abb94/Label-Applicator/pictures/roller_cylinder.jpg

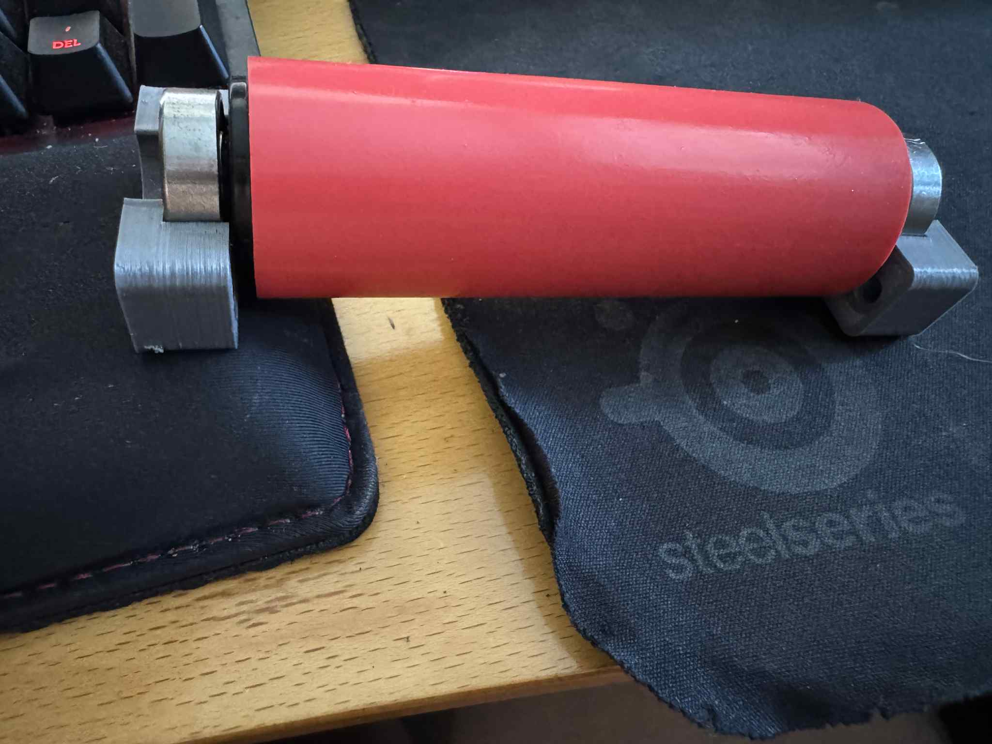
pictures/roller_cylinder.jpg
