abb94/Label-Applicator/pictures/cylinders_1.jpg

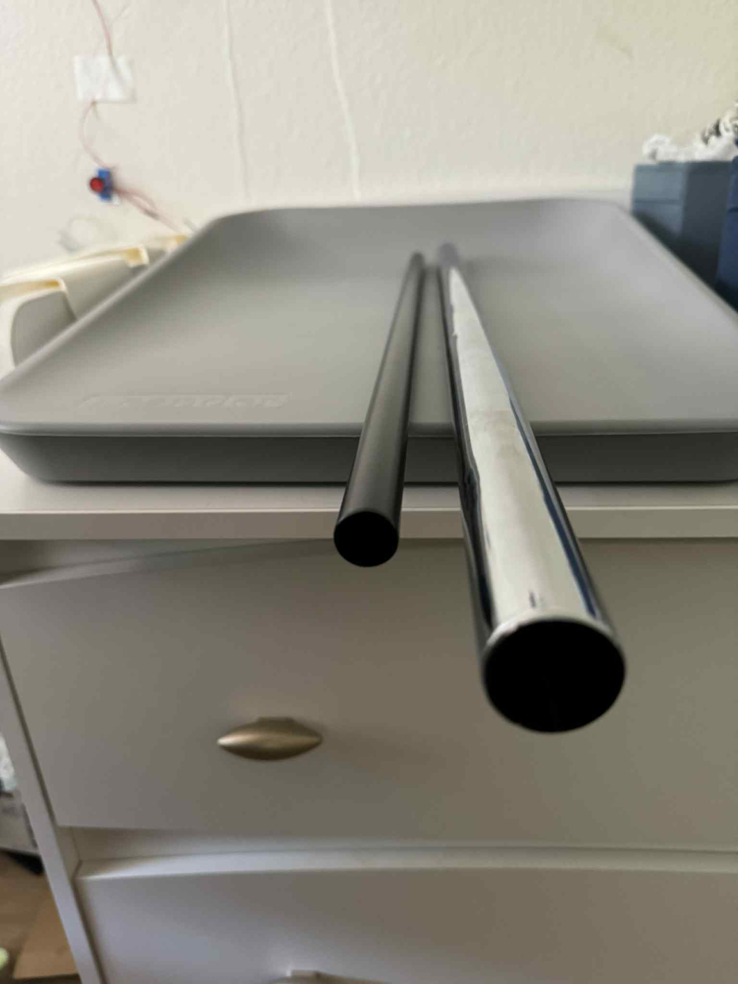
pictures/cylinders_1.jpg
