abb94/Label-Applicator/README.md

# 🏷️ Automated Label Applicator

The goal for this project is to make a cheap and automated DIY Label Applicator for small bottles and flasks with adjustable size, relative to the bottle placed on the device. 

---

## 📚 Table of Contents

- [Introduction](#-introduction)
- [Requirements](#-requirements)
- [Features](#-features)
- [Hardware](#-hardware)
- [Software](#-software)
- [Installation](#-installation)
- [Design Files](#-design-files)
- [Roadmap](#-roadmap)
- [Log](#-log)
- [Learnings](#-learnings)

---

## 🔍 Introduction

This project was created for a friend who is passionate about honey farming. In 2024, his bee colonies produced nearly half a ton of honey. Since each bottle contains roughly half a kilo, that’s about 1,000 bottles to label by hand — a task that’s both time-consuming and far from the most enjoyable part of beekeeping. Commercial automatic label applicators are notoriously expensive, so this project aims to develop a more affordable alternative.

---

## ‼️: Requirements

- [ ] Easy to move around. 
- [ ] Apply labels on different dimensions of glass and label sizes. 
- [ ] Easy to maintain.
- [ ] Easy to use.
- [ ] Semi-automatic and manual to operate. 

---

## ✨ Features

<!-- List the features, for example: automatic feed, sensor detection, calibration, etc. -->

---

## 🔩 Hardware

- 2 x 20 mm x 20 mm x 60 mm I-type profiles
- 3 x 20 mm x 20 mm x 15 mm I-type profiles

---

## 🧠 Software

<!-- Describe the software architecture, languages, frameworks, and any libraries used. -->

---

## ⚙️ Installation

<!-- Step-by-step guide to installing and running the project. Include wiring diagrams or schematics if relevant. -->

---

## 🖼️ Design Files

Current socket design: <br>

Uden titel

---
### 📄: Learnings
- Create a component as the first thing in Fusion 360. Create the body, and the sketch creating that body, and keep it inside the component.
- Tolerances are difficult on a 3d Printer.
- Standardize as much as possible, and don't create several parts from one origin, that fits a niche purpose. It is easier to have the original modified so that it coveres all requirements. 

---
