abb94/Label-Applicator/pictures/3d model socket_on_profile.png

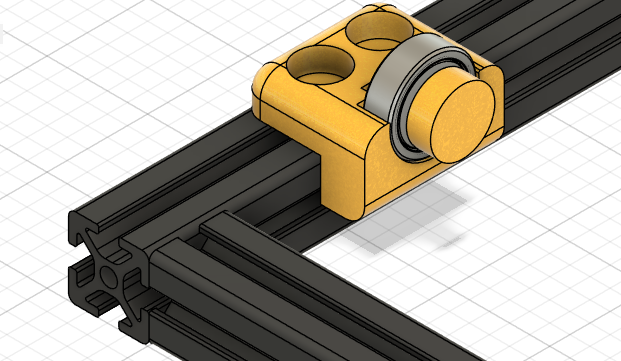
pictures/3d model socket_on_profile.png
