abb94/Label-Applicator/pictures/cylinders_2.jpg

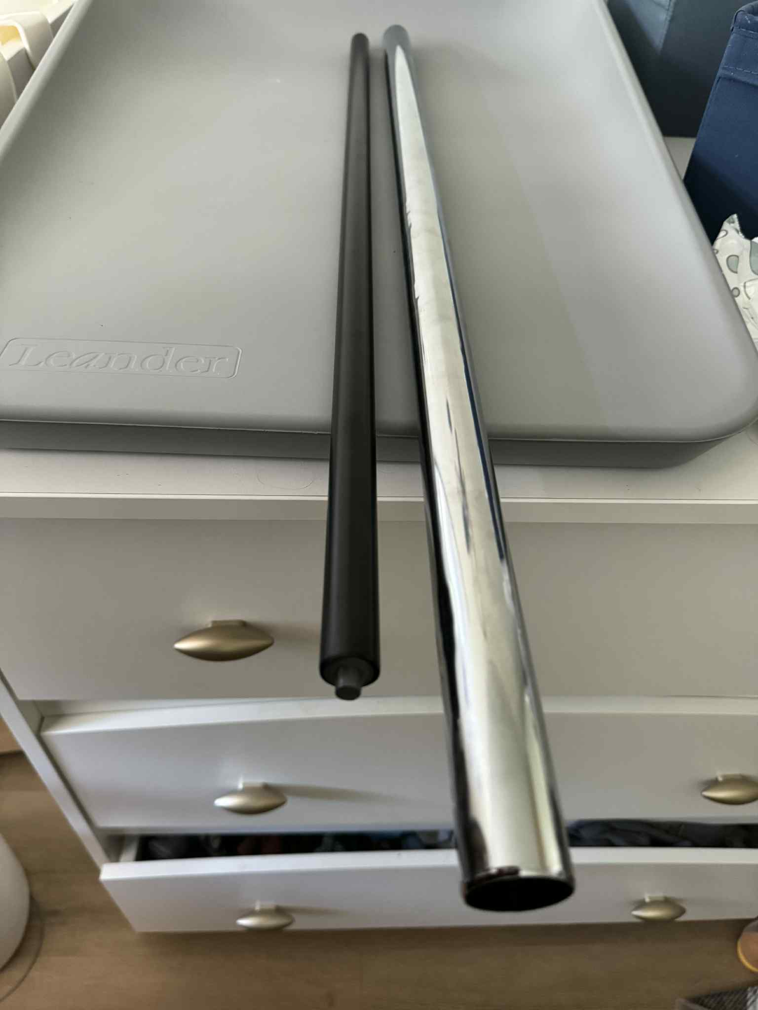
pictures/cylinders_2.jpg
