abb94/Label-Applicator/pictures/profile_bearing_socket_1.jpg

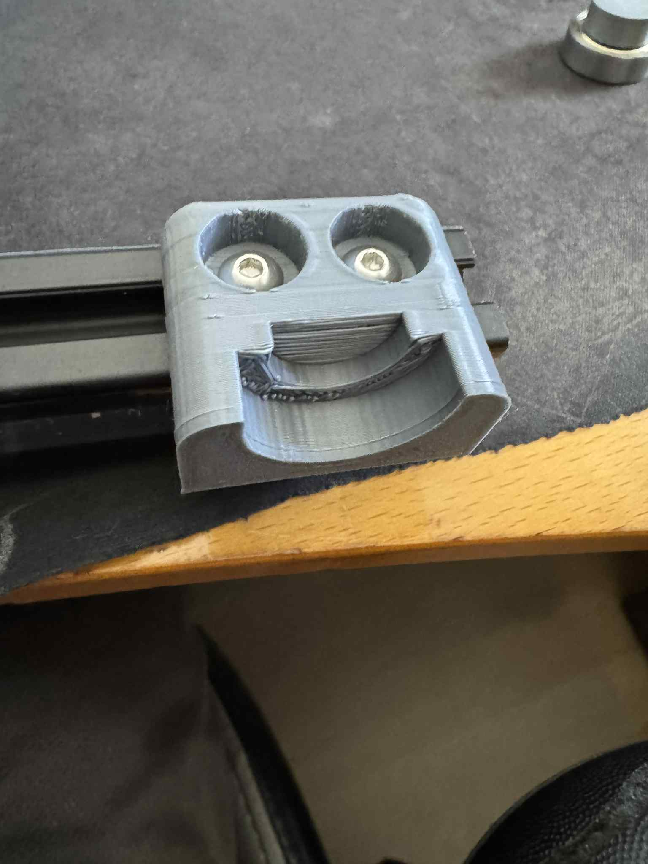
pictures/profile_bearing_socket_1.jpg
