abb94/Label-Applicator/pictures/profile_bearing_socket_2.jpg

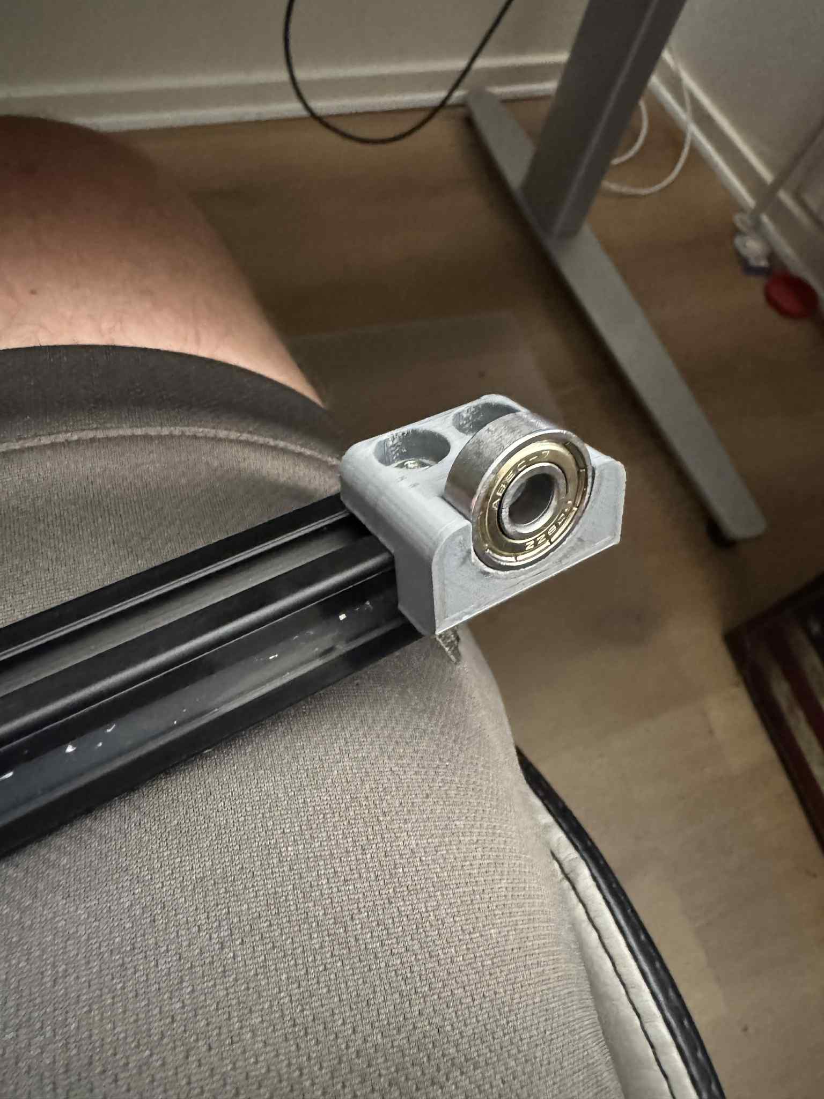
pictures/profile_bearing_socket_2.jpg
