abb94/Label-Applicator/Fusion 360 sketches/Framing_Socket_Sketch.dxf

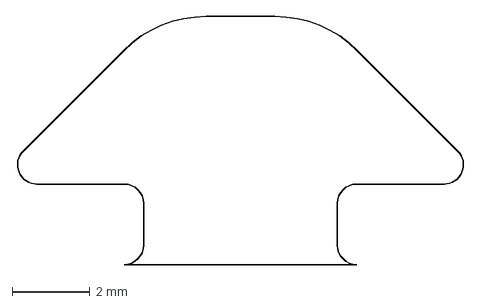
[picture p7: CAD file, 2025-08-17]
Fusion 360 sketches/Framing_Socket_Sketch.dxf
11.6 x 6.40 mm
