abb94/Label-Applicator/STL files/Bearings 8x22x7.step

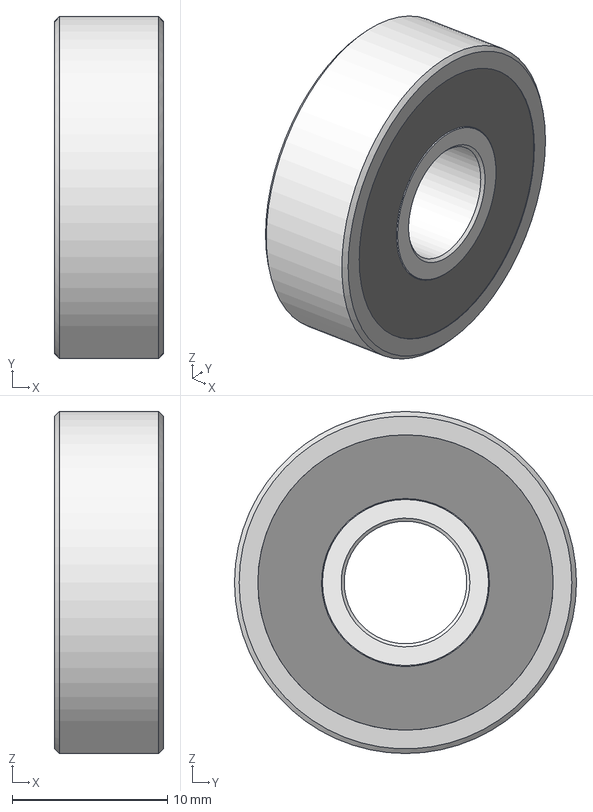
[picture p8: CAD file, 2026-10-25]
STL files/Bearings 8x22x7.step
7.00 x 22.0 x 22.0 mm
Nedre ringen
Mellan ringen
Yttre ringen
Kula x 7
Sidoskydd x 2
