abb94/Label-Applicator/STL files/profile bearing socket/Bearing socket.stl

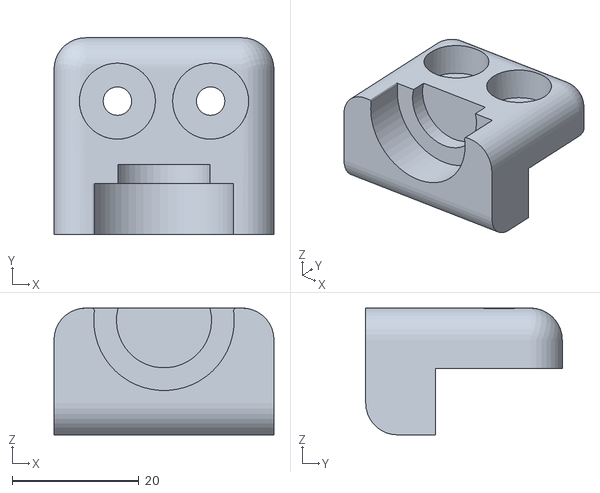
[picture p9: CAD file, 2025-08-17]
STL files/profile bearing socket/Bearing socket.stl
34.7 x 31.0 x 20.0
