abb94/Label-Applicator/STL files/WIP/bridge.stl

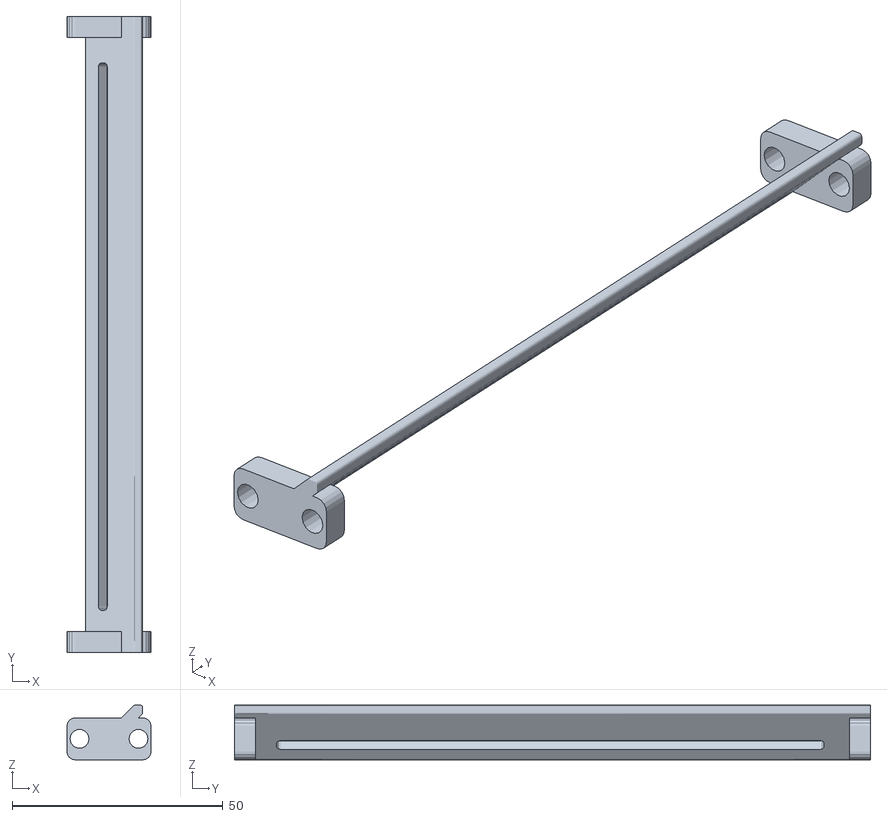
[picture p10: CAD file, 2026-02-08]
STL files/WIP/bridge.stl
20.0 x 151.0 x 13.0
