abb94/Label-Applicator/STL files/WIP/spool allign rod.stl

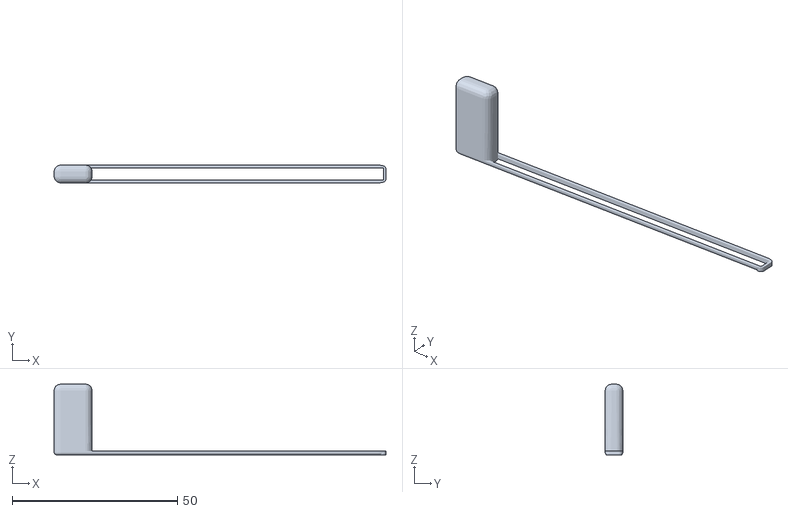
[picture p11: CAD file, 2026-02-08]
STL files/WIP/spool allign rod.stl
100.3 x 5.40 x 21.4
