abb94/Label-Applicator/STL files/WIP/Motorbracket.stl

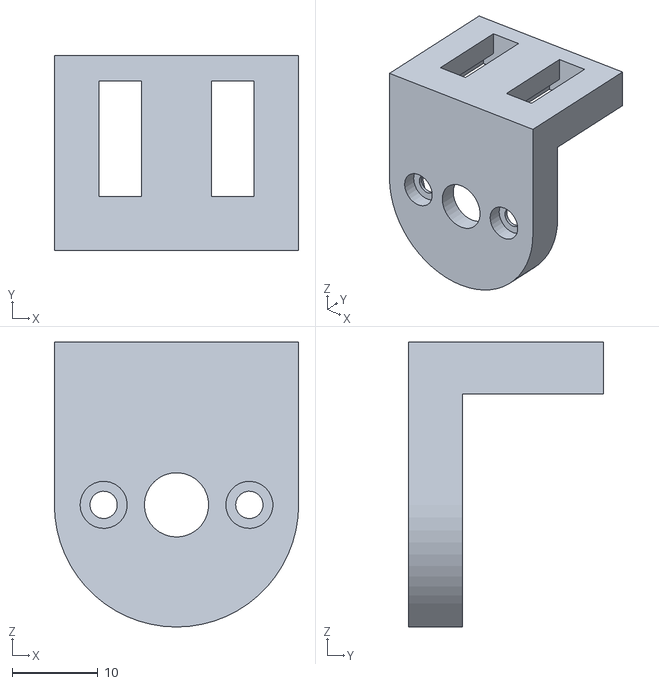
[picture p12: CAD file, 2026-02-08]
STL files/WIP/Motorbracket.stl
28.5 x 22.8 x 33.2
