abb94/Label-Applicator/STL files/WIP/small_fit_adjusted_label.stl

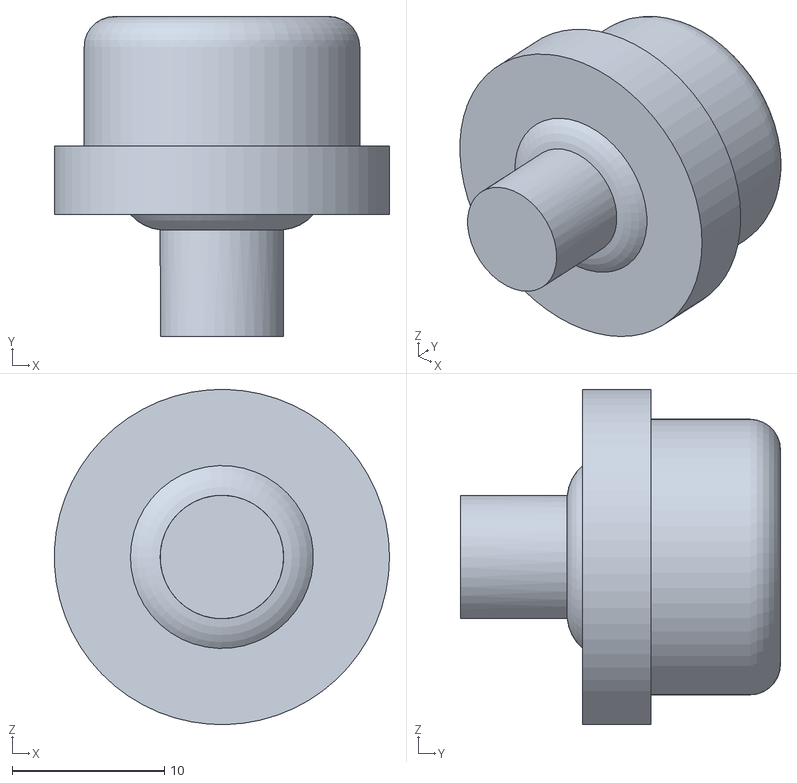
[picture p13: CAD file, 2026-02-08]
STL files/WIP/small_fit_adjusted_label.stl
22.0 x 21.0 x 22.0
