abb94/Label-Applicator/STL files/WIP/BridgeHandle_left.stl

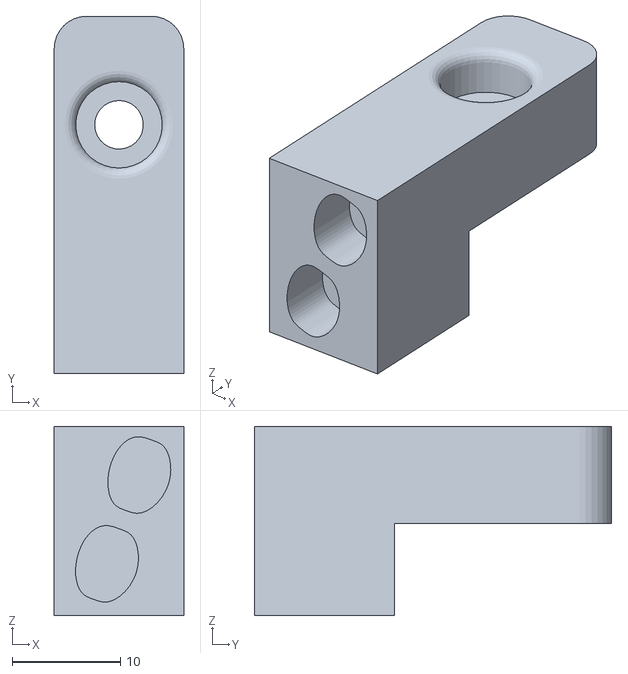
[picture p14: CAD file, 2026-02-08]
STL files/WIP/BridgeHandle_left.stl
12.0 x 33.1 x 17.5
