abb94/Label-Applicator/STL files/WIP/bund.stl

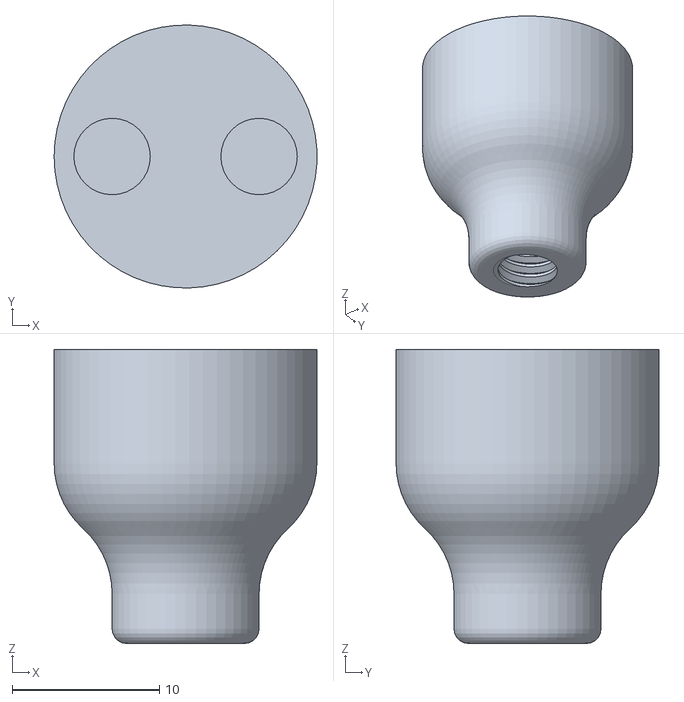
[picture p15: CAD file, 2026-02-08]
STL files/WIP/bund.stl
17.9 x 17.9 x 20.0
