abb94/Label-Applicator/STL files/WIP/label spool holder .stl

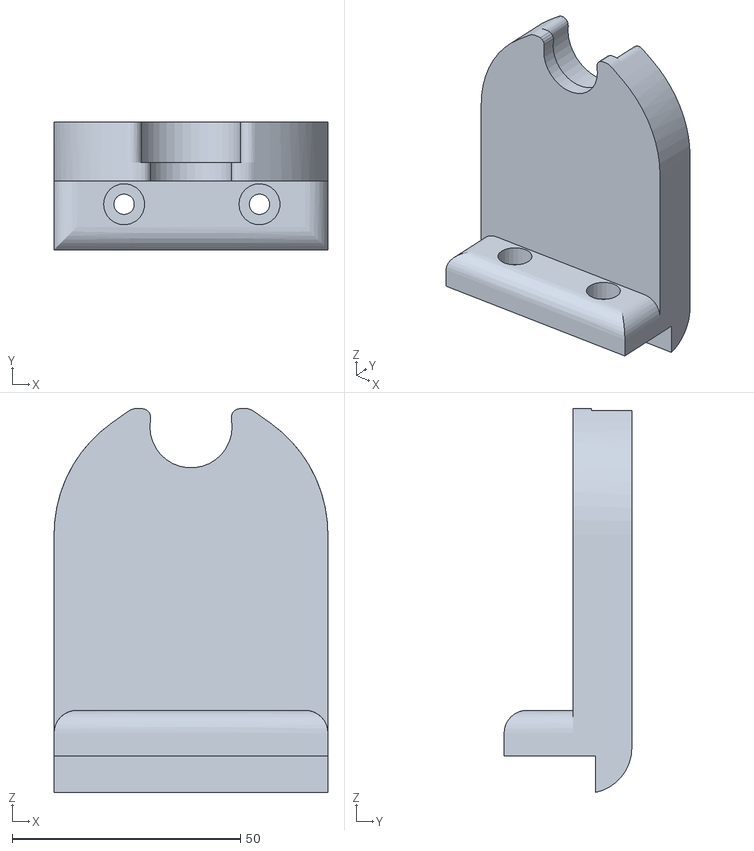
[picture p16: CAD file, 2026-02-08]
STL files/WIP/label spool holder .stl
60.0 x 28.0 x 84.1
