abb94/Label-Applicator/STL files/WIP/test.stl

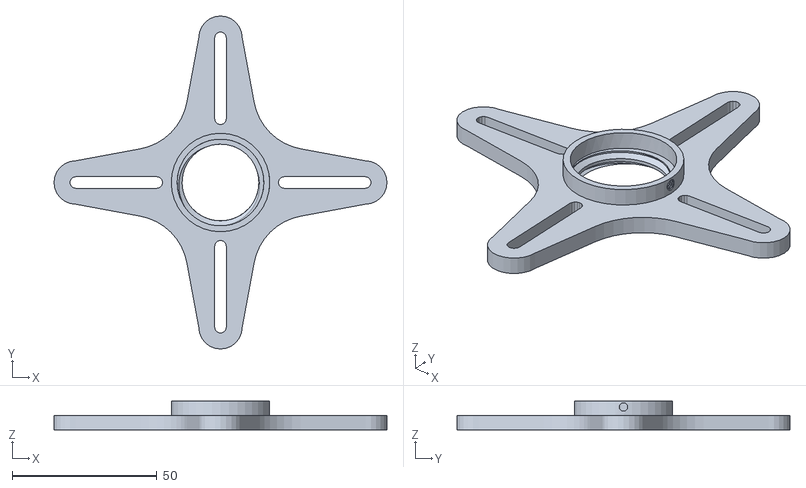
[picture p17: CAD file, 2026-02-08]
STL files/WIP/test.stl
115.0 x 115.0 x 10.0
