abb94/Label-Applicator/STL files/WIP/spool allign socket.stl

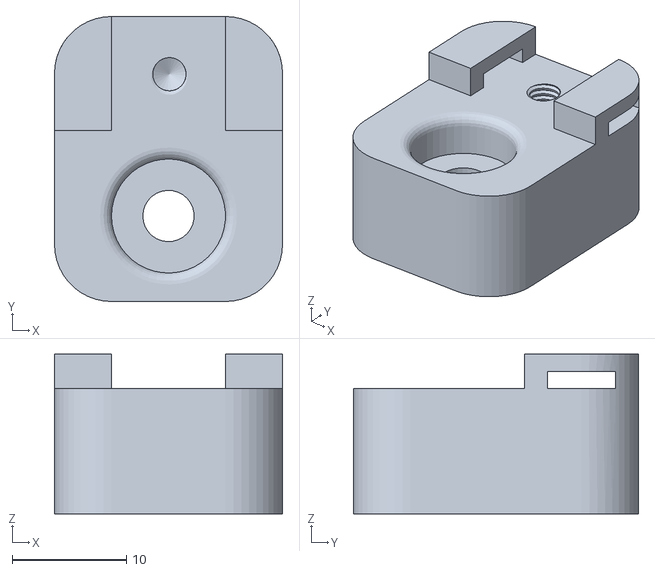
[picture p18: CAD file, 2026-02-08]
STL files/WIP/spool allign socket.stl
20.0 x 25.0 x 14.0
