abb94/Label-Applicator/STL files/WIP/Stand socket.stl

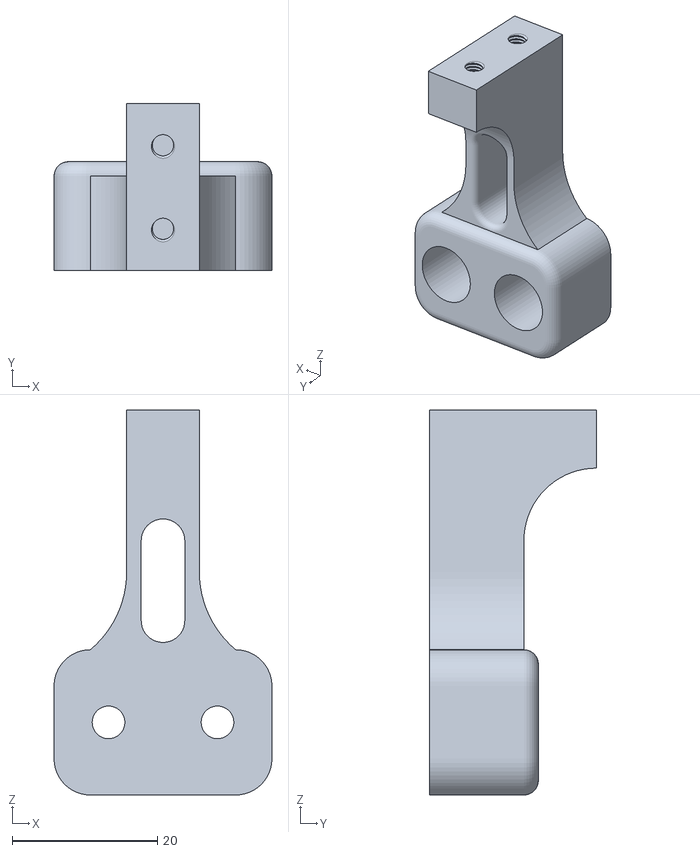
[picture p19: CAD file, 2026-02-08]
STL files/WIP/Stand socket.stl
30.0 x 23.0 x 53.0
