abb94/Label-Applicator/STL files/WIP/kombineret fod.stl

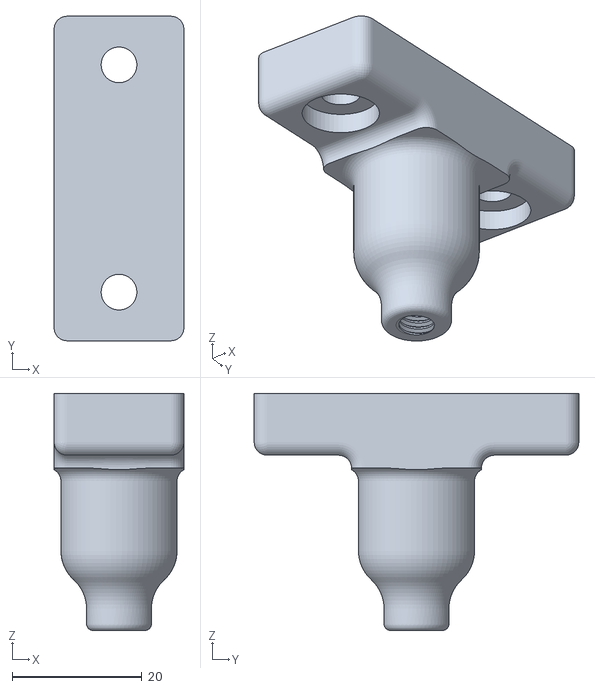
[picture p20: CAD file, 2026-02-08]
STL files/WIP/kombineret fod.stl
20.0 x 50.0 x 36.5
