abb94/Label-Applicator/STL files/WIP/top.stl

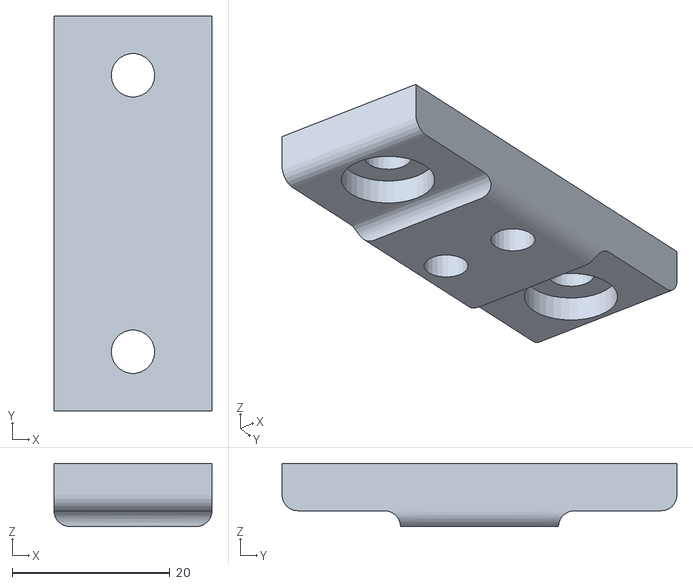
[picture p21: CAD file, 2026-02-08]
STL files/WIP/top.stl
20.0 x 50.0 x 8.00
