abb94/Label-Applicator/STL files/WIP/IR holder stand.stl

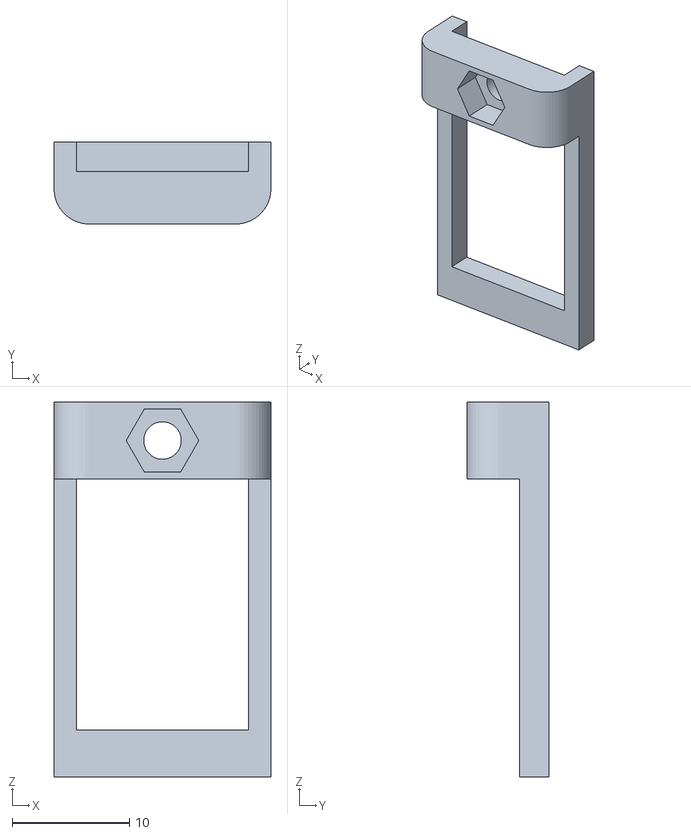
[picture p22: CAD file, 2026-02-08]
STL files/WIP/IR holder stand.stl
18.5 x 7.00 x 32.0
