abb94/Label-Applicator/STL files/WIP/small fit.stl

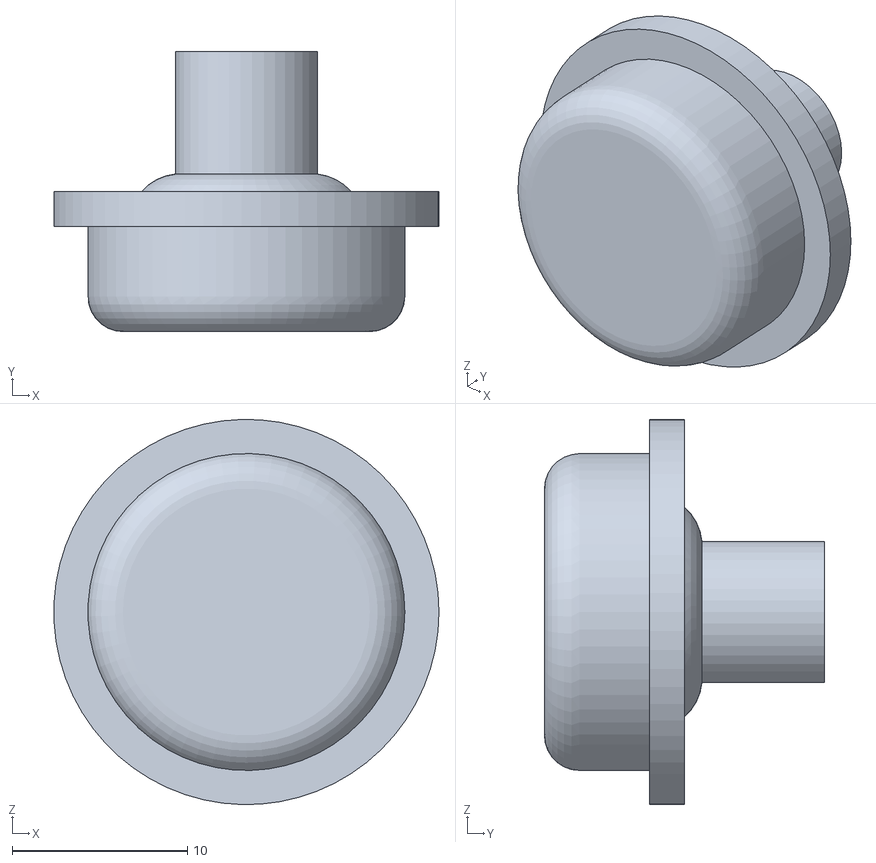
[picture p23: CAD file, 2026-02-08]
STL files/WIP/small fit.stl
22.0 x 16.0 x 22.0
