abb94/Label-Applicator/STL files/WIP/medium fit.stl

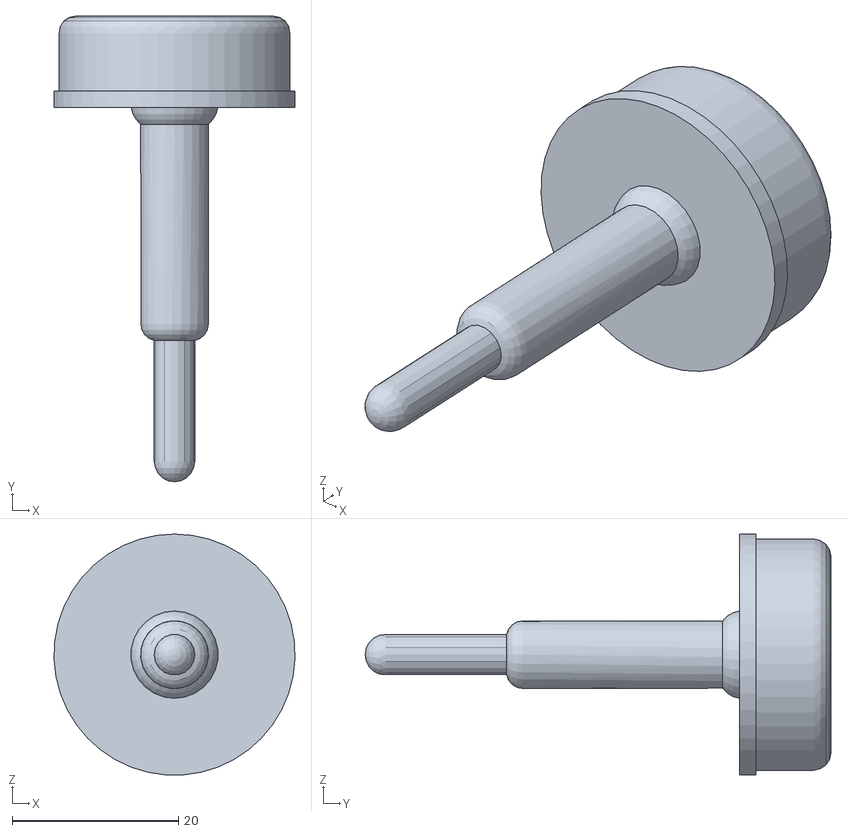
[picture p24: CAD file, 2026-02-08]
STL files/WIP/medium fit.stl
29.0 x 56.0 x 29.0
