abb94/Label-Applicator/STL files/WIP/rod.stl

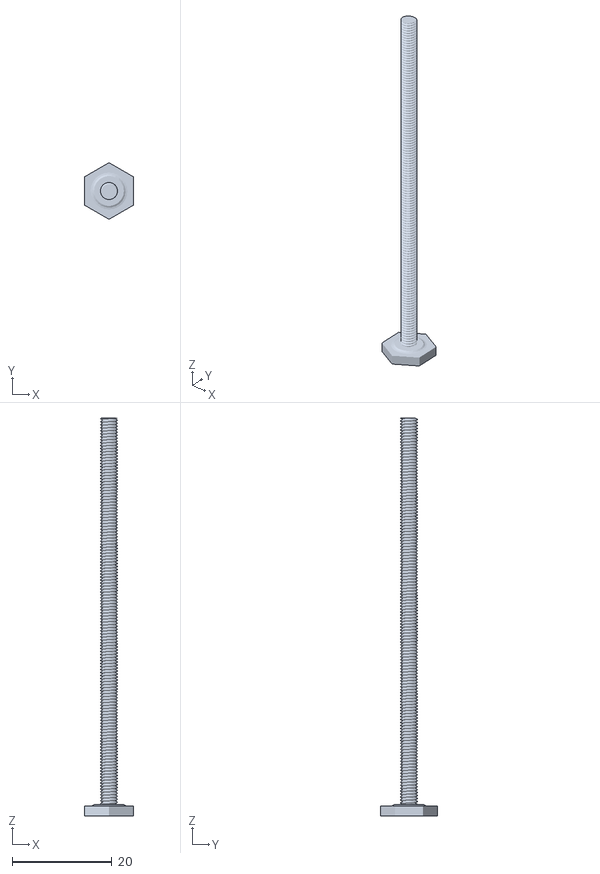
[picture p25: CAD file, 2026-02-08]
STL files/WIP/rod.stl
9.85 x 11.4 x 80.0
