abb94/Label-Applicator/STL files/WIP/test spool holder.stl

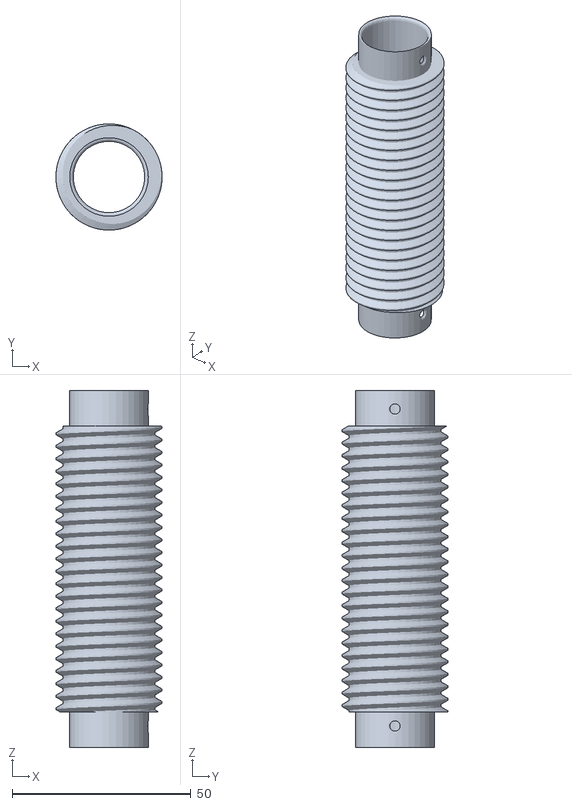
[picture p26: CAD file, 2026-02-08]
STL files/WIP/test spool holder.stl
29.7 x 29.7 x 100.0
