abb94/Label-Applicator/STL files/WIP/Stand rod.stl

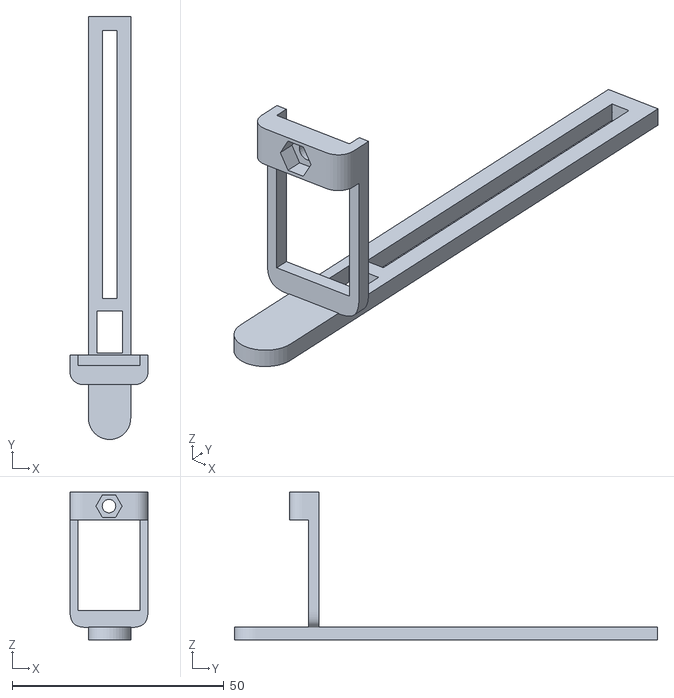
[picture p27: CAD file, 2026-02-08]
STL files/WIP/Stand rod.stl
18.5 x 100.0 x 34.9
