abb94/Label-Applicator/STL files/WIP/medium extended fit.stl

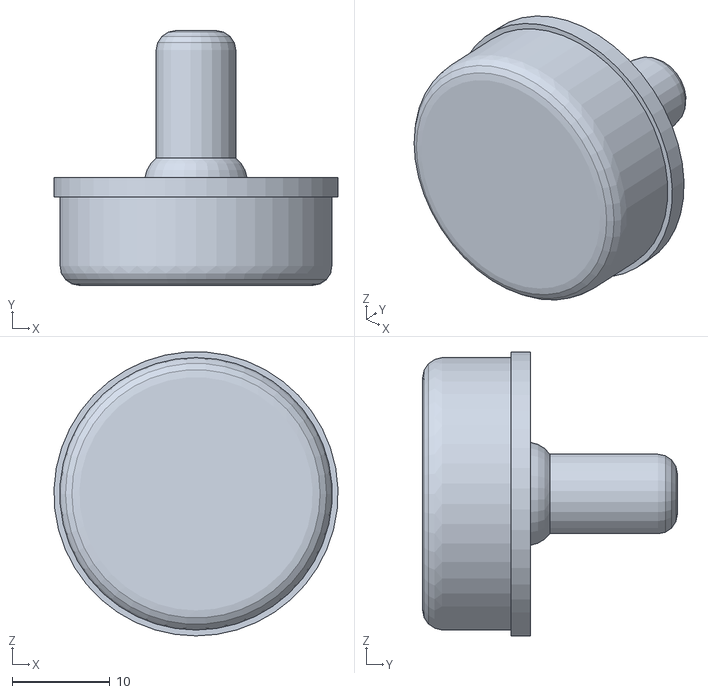
[picture p28: CAD file, 2026-02-08]
STL files/WIP/medium extended fit.stl
29.0 x 26.0 x 29.0
