abb94/Label-Applicator/STL files/WIP/label alligner.stl

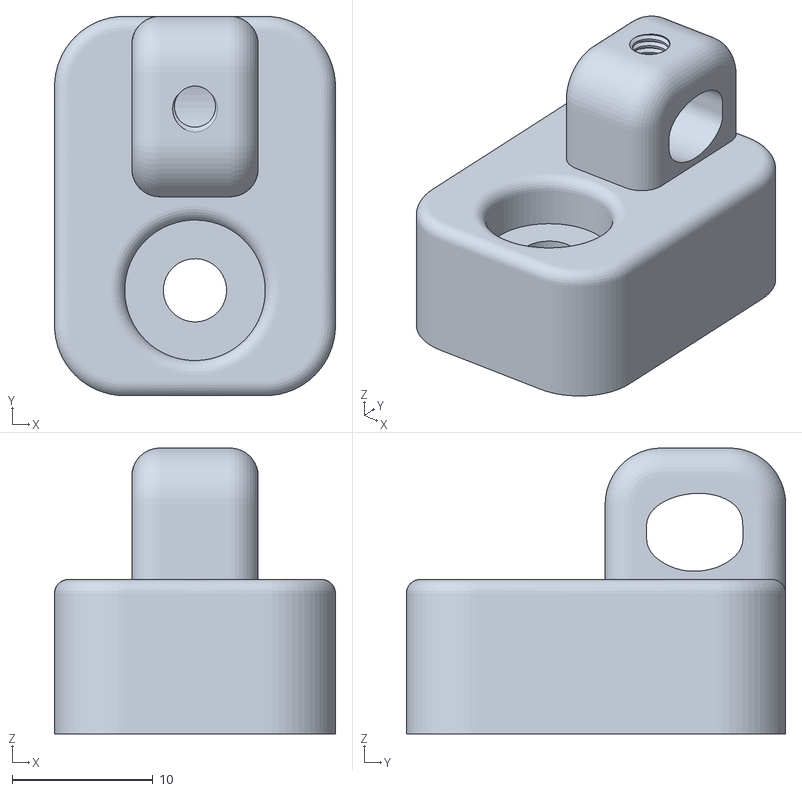
[picture p29: CAD file, 2026-02-08]
STL files/WIP/label alligner.stl
20.0 x 27.0 x 20.4
