abb94/Label-Applicator/STL files/WIP/IR holder.stl

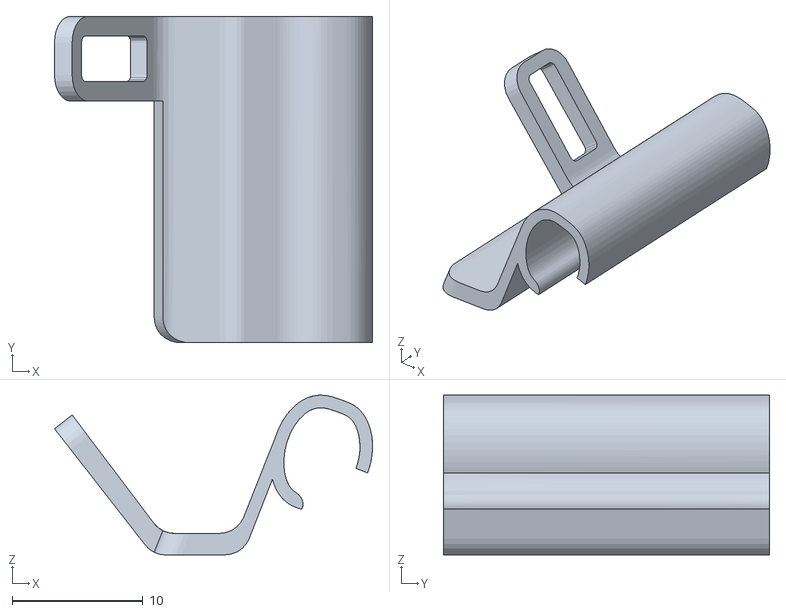
[picture p30: CAD file, 2026-02-08]
STL files/WIP/IR holder.stl
24.4 x 25.0 x 12.2
