abb94/Label-Applicator/STL files/WIP/small socket.stl

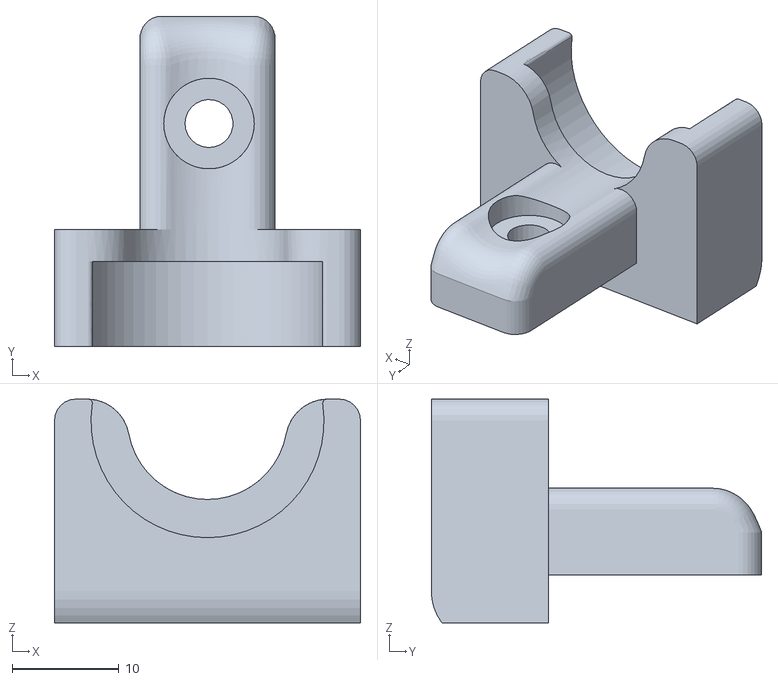
[picture p31: CAD file, 2026-02-08]
STL files/WIP/small socket.stl
28.7 x 31.0 x 21.0
