abb94/Label-Applicator/STL files/WIP/Lille 1.stl

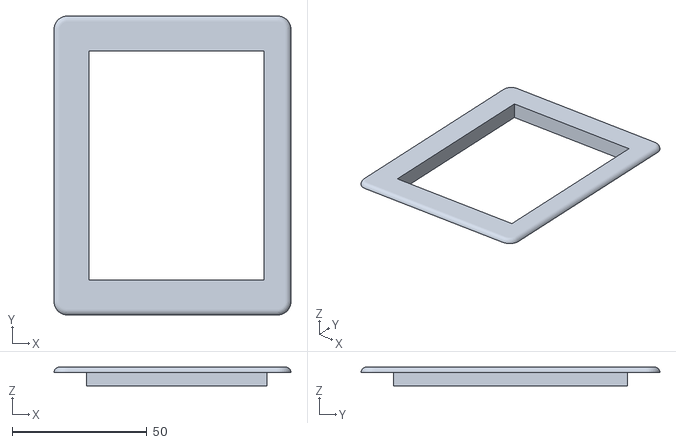
[picture p32: CAD file, 2026-02-08]
STL files/WIP/Lille 1.stl
88.0 x 111.0 x 7.00
