abb94/Label-Applicator/(list of files, cad)

Other CAD files:
STL files/WIP/small_fit_right.stl
STL files/WIP/test2.stl
STL files/WIP/BridgeHandle.stl
STL files/WIP/BridgeHandle_Right.stl
STL files/Assembled Bearing 8x22x7 v15.f3z
STL files/NEMA17 stepper motor v39.f3d
STL files/WIP/bolt.stl
STL files/WIP/feet screw.stl
STL files/WIP/label spool holder.stl
