abb94/Label-Applicator/Logs/V2 - Current build.md

## 📗: Log

### 25th of October 2026 <br>

I disassembled my version 1 today. The biggest issue on the last version was: 
- My choice of IR sensor. 
- The sudden stop of momentum from the motor, resulting in a "loose" circuit from the spool input and until it was labelled upon a honey glass.

My first objective is to have a tightened loop between the spool input and spool output. 
- **Spool input**: The spool and paper with labels on, which will be applied upon the glass. 
- **Spool output**: The mechanism that *drags* the paper that has been used and removes the paper from the circuit.

I will aim to have a gear on both the input section and output section. This should reduce the possibility of momentum creating a loose circuit, since the stepper motor will stop the motion instantly in both sections of the circuit.
