abb94/Label-Applicator/PCB/Main/Main.kicad_pcb

## KiCad design PCB/Main/Main.kicad_pcb (2026-10-21)

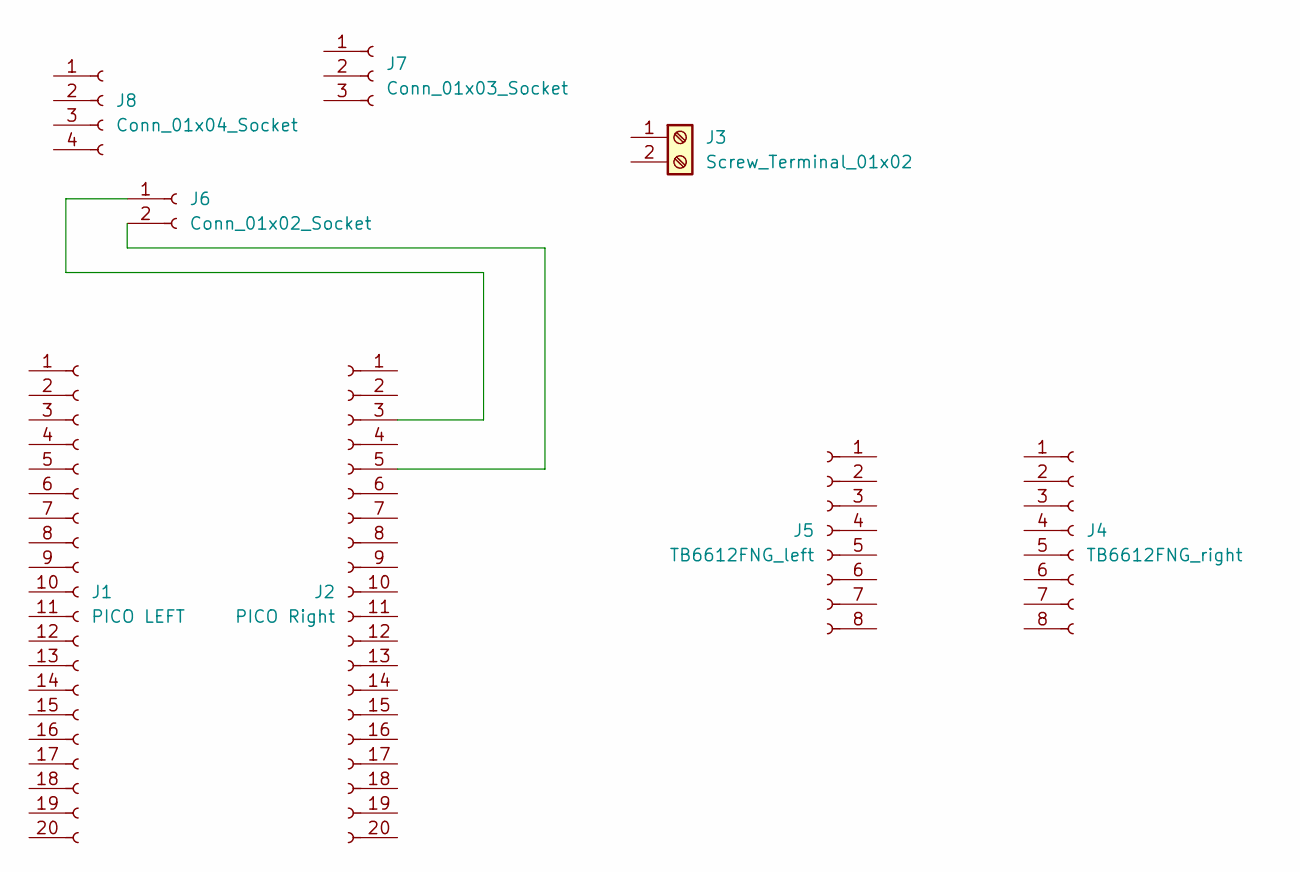
[picture p33: schematic Main.kicad_sch]

Parts:
J1: PICO LEFT; PinSocket_1x20_P2.54mm_Vertical
J2: PICO Right; PinSocket_1x20_P2.54mm_Vertical
J3: Screw_Terminal_01x02; TerminalBlock_MetzConnect_Type073_RT02602HBLU_1x02_P5.08mm_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
J4: TB6612FNG_right; PinSocket_1x08_P2.54mm_Vertical
J5: TB6612FNG_left; PinSocket_1x08_P2.54mm_Vertical
J6: Conn_01x02_Socket; JST_XH_B2B-XH-A_1x02_P2.50mm_Vertical
J7: Conn_01x03_Socket; JST_XH_B3B-XH-A_1x03_P2.50mm_Vertical
J8: Conn_01x04_Socket; JST_XH_B4B-XH-A_1x04_P2.50mm_Vertical

Connections:
unnamed: J2.3, J6.1
unnamed: J2.5, J6.2

Board: 2 copper layers, 8 parts (0 on the bottom side), 2 nets, no tracks yet.
