abb94/Label-Applicator/(commit log)

2025-08-02 Create Framing_Socket_Sketch.dxf
    Tilføjelse af sketch til profil
    [Framing_Socket_Sketch.dxf]
2025-08-17 Added pictures and maintained library.
    Added pictures and maintained library.
    [Bearing socket.stl, Framing_Socket_Sketch.dxf, Own bearing adapter 8.10 mm.stl, Own bearing adapter 8.15 mm.stl, Socket left.stl]
2026-02-08 TIlføjelse af filer.
    TIlføjelse af filer.
    [BridgeHandle.stl, BridgeHandle_Right.stl, BridgeHandle_left.stl, IR holder stand.stl, IR holder.stl, Lille 1.stl, Main.kicad_pcb, Main.kicad_sch]
2026-02-28 PCB editing
    changes to footprints.
    [Main.kicad_pcb, Main.kicad_sch]
2026-02-28 PLACED TB6612FNG Motor driver on schematic.
    [Main.kicad_pcb, Main.kicad_sch]
2026-10-03 Update README.md
    Added new log entry - Haven't worked on the project since spring of 2026.
2026-10-21 3step file
    Inserted 3step file of nema 17 42x42x23.
    [Main.kicad_pcb, Main.kicad_sch, NEMA17 stepper motor v39.f3d]
2026-10-25 Create V2 - Current build
2026-10-25 Push newest
    [Assembled Bearing 8x22x7 v15.f3z, Bearings 8x22x7.step]
2026-10-25 Update and rename V2 - Current build to V2 - Current build.md
